OLIMEX/iCE40HX8K-EVB/README.md

# iCE40HX8K-EVB
iCE40HX8K development board with SRAM and bus for fast ADC, DAC, IOs
