OLIMEX/iCE40HX8K-EVB/demo/ice40hx8k-evb/README

This example is for iCE40HX8K-EVB board 

www.olimex.com/wiki/iCE40HX8K-EVB

you need OLIMEXINO-32U4 set as programmer to program the board
