OLIMEX/iCE40HX8K-EVB/HARDWARE/REV-B1/iCE40HX8K-EVB_Rev_B1.pdf

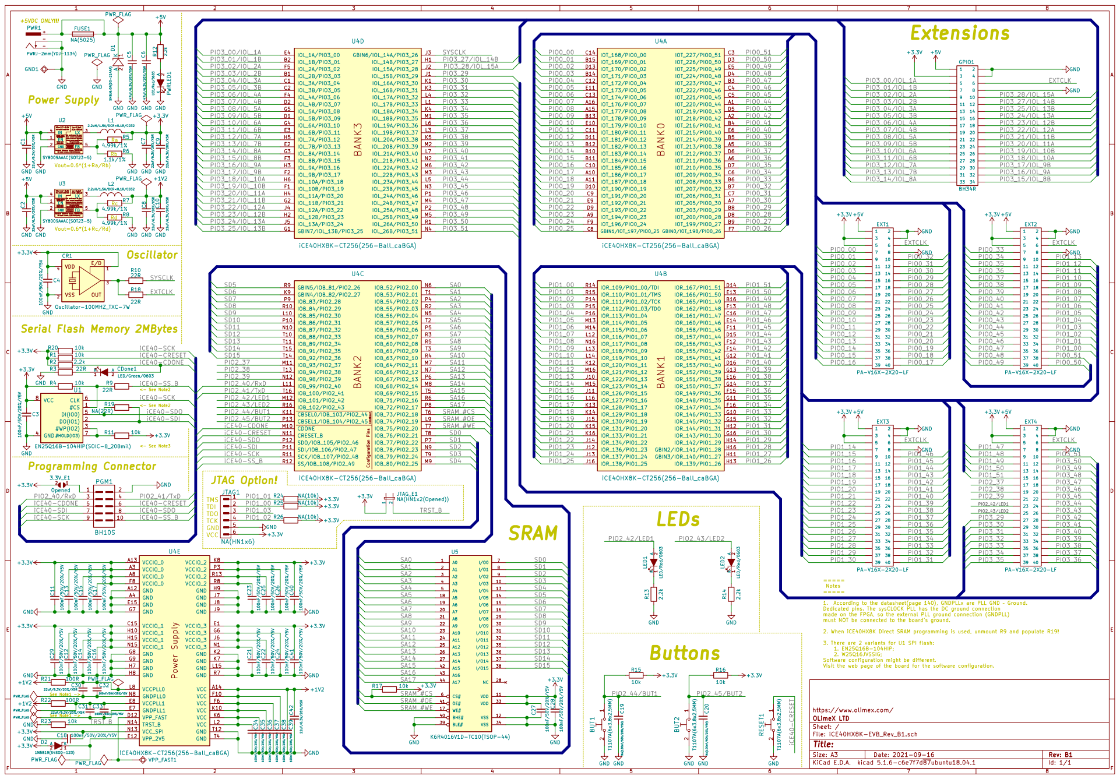
[picture p1: page 1]

Do not float. Enable control. FB Input Current, I(FB)=50nA(max) Feedback Reference Voltage, V(REF)=0.6V

load current capability! Lx=2.2uH

1. According to the datasheet(page 140), GNDPLLx are PLL GND Ground. Dedicated pins. The sysCLOCK PLL has the DC ground connection made on the FPGA, so the external PLL ground connection (GNDPLL) must NOT be connected to the boards ground. 2. When iCE40HX8K Direct SRAM programming is used, unmount R9 and populate R19! 3. There are 2 variants for U1 SPI flash:

1. EN25Q16B-104HIP;
2. W25Q16JVSSIG; Software configuration might be different. Visit the web page of the board for the software configuration.

https://www.olimex.com/
Id: 1/1 Title: File: iCE40HX8K-EVB_Rev_B1.sch Sheet: / OLimeX LTD
