OLIMEX/iCE40HX8K-EVB/HARDWARE/REV-B/iCE40HX8K-EVB_Rev_B.pdf

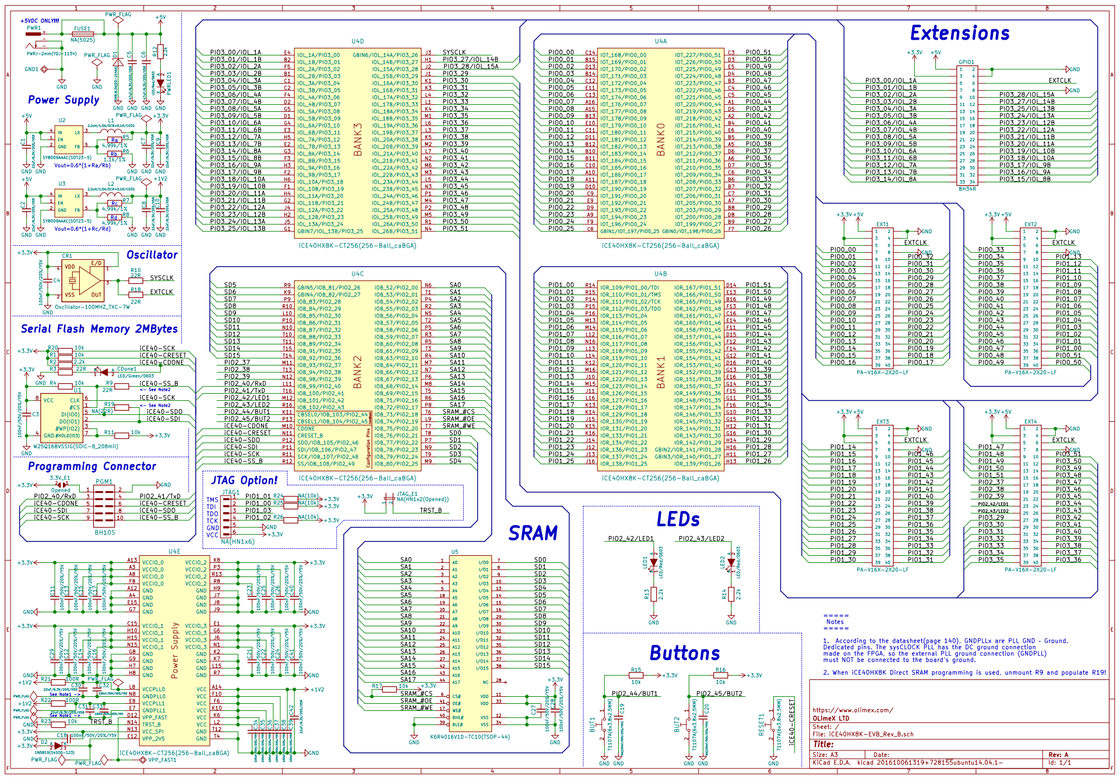
[picture p2: page 1]

2 PWRLED1 LED/Red/0603 R12 2.2k GND C1 22uF/6.3V/20%/X5R GND
iCE40HX8K-CT256(256-Ball_caBGA) BANK3

https://www.olimex.com/
Id: 1/1 Title: File: iCE40HX8K-EVB_Rev_B.sch Sheet: / OLimeX LTD
