OLIMEX/iCE40HX8K-EVB/HARDWARE/REV-B1/iCE40HX8K-EVB_Rev_B1.kicad_pcb

## KiCad design HARDWARE/REV-B1/iCE40HX8K-EVB_Rev_B1.kicad_pcb (2021-09-16)

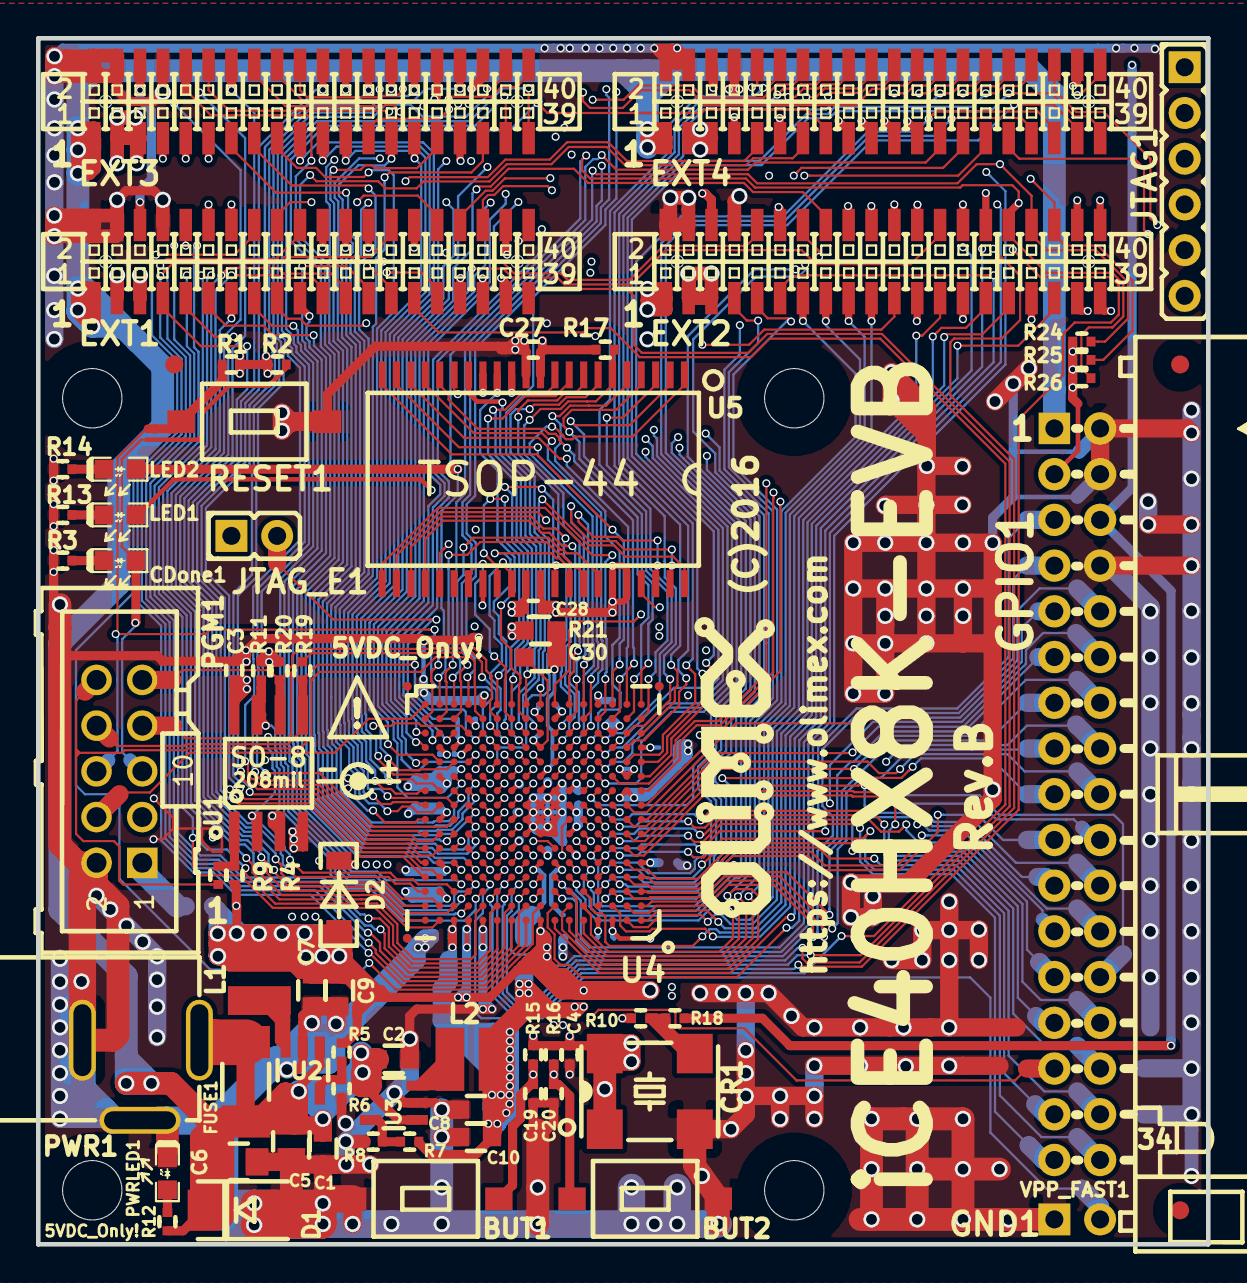
[picture p3: board iCE40HX8K-EVB_Rev_B1.kicad_pcb from above]

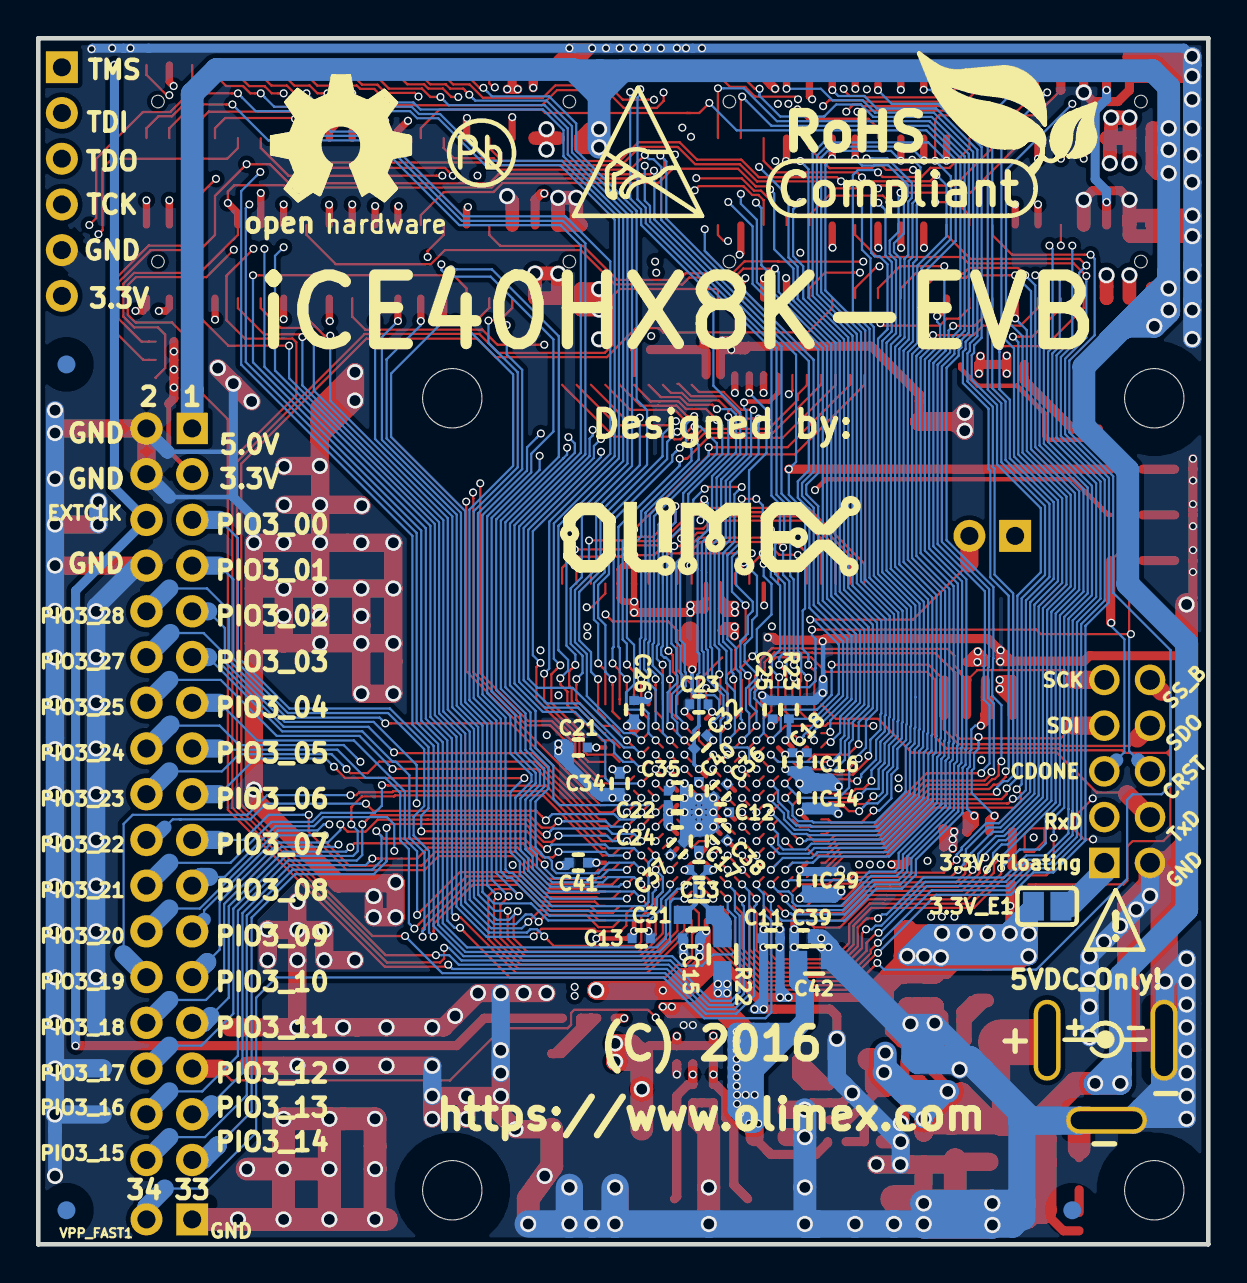
[picture p4: board iCE40HX8K-EVB_Rev_B1.kicad_pcb from below]

Board: 4 copper layers, 65.0 x 67.0 mm, 104 parts (32 on the bottom side), 232 nets.

Parts:
3.3V_E1: Opened; SJ
BUT1, BUT2: T1107A(6x3,8x2,5MM)
C1, C2, C7, C8, C9, C10, C30, C31, C42: 22uF/6.3V/20%/X5R; C_0603_5MIL_DWS
C3, C4, C11, C12, C13, C14, C15, C16, C17, C18, C21, C22, C23, C24, C25, C26, C27, C28, C29, C32, C33, C34, C35, C36, C37, C38, C39, C40, C41: 100nF/50V/20%/Y5V; C_0402_5MIL_DWS
C5, C6: 47uF/6.3V/20%/X5R; C_0805_5MIL_DWS
C19, C20: NA(100nF/50V/20%/Y5V); C_0402_5MIL_DWS
CDone1: LED/Green/0603; LED_0603_KA
CR1: Oscillator-100MHZ_TXC-7W; Oscillator_7.0x5.0mm
D1: SMBJ6.0A(DO-214AA); DO214AA_1(K)-2(A)
D2: 1N5819(S4SOD-123); SOD-123_1C-2A_KA
EXT1, EXT2, EXT3, EXT4: PA-V16X-2X20-LF; GPH127SMT-02X20(PA-V16X-2X20-LF)
FUSE1: NA(5025); FUSE-5025
GND1: TESTPAD; TEST_PAD40x70_SQUARE
GPIO1: BH34R
JTAG1: NA(HN1x6); HN1x6
JTAG_E1: NA(HN1x2(Opened)); HN1x2
L1, L2: 2.2uH/1.5A/DCR<0.1R/CD32; CD32
LED1, LED2: LED/Red/0603; LED_0603_KA
MountingHole: Mounting_hole_3.3mm
MountingHole#2, MountingHole#3, MountingHole#4: Mounting_hole_3.3mm
PGM1: BH10S; UEXT_ML10
PWR1: PWRJ-2mm(YDJ-1134); PWRJ-2mm(YDJ-1136)
PWRLED1: LED/Red/0603; LED_0603_KA
R1, R4, R11, R15, R16, R17, R20, R23: 10k; R_0402_5MIL_DWS
R2, R12, R13, R14: 2.2k; R_0402_5MIL_DWS
R3, R9, R10, R18: 22R; R_0402_5MIL_DWS
R5, R7, R8: 4.99k/1%; R_0402_5MIL_DWS
R6: 1.1k/1%; R_0402_5MIL_DWS
R19: NA(22R); R_0402_5MIL_DWS
R21, R22: 100R; R_0603_5MIL_DWS
R24, R25, R26: NA(10k); R_0402_5MIL_DWS
RESET1: T1107A(6x3,8x2,5MM)
Ref**: Val**; LOGO_ROHS_1
Ref**#2: Val**; LOGO_ANTISTATIC_1
U1: EN25Q16B-104HIP(SOIC-8_208mil); SO-8_208mil
U2, U3: SY8009AAAC(SOT23-5); SOT-23-5
U4: iCE40HX8K-CT256(256-Ball_caBGA); 256-Ball_caBGA(Pitch_0.80mm_Pad_0.40mm)
U5: K6R4016V1D-TC10(TSOP-44); TSOP-44_Pitch-0.80mm_18.80x11.80x1.20mm
VPP_FAST1: TESTPAD; TEST_PAD_40x70_Round

Connections:
+1V2: C8.2, C10.2, C34.2, C35.2, C36.2, C37.2, C38.2, C39.2, C42.1, L2.1, R7.2, R21.2, R22.2, U4.A14, U4.F6, U4.F10, U4.K6, U4.K10, U4.L2
+3V3: 3.3V_E1.2, C3.2, C4.2, C7.2, C9.2, C11.2, C12.2, C13.2, C14.2, C15.2, C16.2, C17.2, C18.1, C21.2, C22.2, C23.2, C24.2, C25.2, C26.2, C27.2, C28.2, C29.2, C40.2, C41.2, CR1.1, CR1.4, D2.2, EXT1.3, EXT1.5, EXT2.3, EXT2.5, EXT3.3, EXT3.5, EXT4.3, EXT4.5, GPIO1.3, JTAG1.6, JTAG_E1.1, L1.1, R1.2, R2.2, R4.2, R5.2, R11.1, R15.2, R16.2, R17.1, R20.2, R24.1, R25.1, R26.1, U1.8, U4.A3, U4.A8, U4.A13, U4.C15, U4.E1, U4.F8, U4.G6, U4.H10, U4.H15, U4.J6, U4.K8, U4.N1, U4.N13, U4.N15, U4.P3, U4.R8, U4.R13, U5.11, U5.33
+5V: C1.2, C2.2, C5.2, C6.2, D1.1, EXT1.1, EXT2.1, EXT3.1, EXT4.1, FUSE1.1, FUSE1.2, GPIO1.1, PWR1.+, R12.1, U2.1, U2.4, U3.1, U3.4
/EXTCLK: EXT1.6, EXT2.6, EXT3.6, EXT4.6, GPIO1.6, R18.1
/PIO0_00: EXT1.7, U4.C14
/PIO0_01: EXT1.9, U4.B15
/PIO0_02: EXT1.11, U4.D13
/PIO0_03: EXT1.13, U4.B14
/PIO0_04: EXT1.15, U4.C12
/PIO0_05: EXT1.17, U4.E11
/PIO0_06: EXT1.19, U4.C13
/PIO0_07: EXT1.21, U4.A16
/PIO0_08: EXT1.23, U4.A15
/PIO0_09: EXT1.25, U4.B13
/PIO0_10: EXT1.27, U4.E10
/PIO0_11: EXT1.29, U4.C11
/PIO0_12: EXT1.31, U4.D11
/PIO0_13: EXT1.33, U4.B12
/PIO0_14: EXT1.35, U4.B10
/PIO0_15: EXT1.37, U4.B11
/PIO0_16: EXT1.39, U4.C10
/PIO0_17: EXT1.40, U4.A10
/PIO0_18: EXT1.38, U4.A11
/PIO0_19: EXT1.36, U4.D10
/PIO0_20: EXT1.34, U4.C9
/PIO0_21: EXT1.32, U4.E9
/PIO0_22: EXT1.30, U4.D9
/PIO0_23: EXT1.28, U4.A9
/PIO0_24: EXT1.26, U4.F9
/PIO0_25: EXT1.24, U4.C8
/PIO0_26: EXT1.22, U4.F7
/PIO0_27: EXT1.20, U4.B9
/PIO0_28: EXT1.18, U4.D8
/PIO0_29: EXT1.16, U4.B8
/PIO0_30: EXT1.14, U4.A7
/PIO0_31: EXT1.12, U4.C7
/PIO0_32: EXT1.10, U4.B7
/PIO0_33: EXT2.7, U4.B6
/PIO0_34: EXT2.9, U4.C6
/PIO0_35: EXT2.11, U4.D7
/PIO0_36: EXT2.13, U4.A6
/PIO0_37: EXT2.15, U4.D6
/PIO0_38: EXT2.17, U4.A5
/PIO0_39: EXT2.19, U4.B5
/PIO0_40: EXT2.21, U4.E6
/PIO0_41: EXT2.23, U4.B4
/PIO0_42: EXT2.25, U4.A2
/PIO0_43: EXT2.27, U4.D5
/PIO0_44: EXT2.29, U4.A1
/PIO0_45: EXT2.31, U4.C5
/PIO0_46: EXT2.33, U4.C4
/PIO0_47: EXT2.35, U4.B3
/PIO0_48: EXT2.37, U4.D4
/PIO0_49: EXT2.39, U4.E5
/PIO0_50: EXT2.40, U4.D3
/PIO0_51: EXT2.38, U4.C3
/PIO1_00: EXT2.36, JTAG1.2, R25.2, U4.R14
/PIO1_01: EXT2.34, JTAG1.1, R24.2, U4.R15
/PIO1_02: EXT2.32, JTAG1.4, R26.2, U4.P14
/PIO1_03: EXT2.30, JTAG1.3, U4.P15
/PIO1_04: EXT2.28, U4.P16
/PIO1_05: EXT2.26, U4.M13
/PIO1_06: EXT2.24, U4.M14
/PIO1_07: EXT2.22, U4.L12
/PIO1_08: EXT2.20, U4.N16
/PIO1_09: EXT2.18, U4.L13
/PIO1_10: EXT2.16, U4.L14
/PIO1_11: EXT2.14, U4.K12
/PIO1_12: EXT2.12, U4.M16
/PIO1_13: EXT2.10, U4.J10
/PIO1_14: EXT3.7, U4.M15
/PIO1_15: EXT3.9, U4.J11
/PIO1_16: EXT3.11, U4.L16
/PIO1_17: EXT3.13, U4.K13
/PIO1_18: EXT3.15, U4.K14
/PIO1_19: EXT3.17, U4.J15
/PIO1_20: EXT3.19, U4.K15
/PIO1_21: EXT3.21, U4.K16
/PIO1_22: EXT3.23, U4.J14
/PIO1_23: EXT3.25, U4.J12
/PIO1_24: EXT3.27, U4.J13
/PIO1_25: EXT3.29, U4.J16
/PIO1_26: EXT3.31, U4.H13
/PIO1_27: EXT3.33, U4.H11
/PIO1_28: EXT3.35, U4.H16
/PIO1_29: EXT3.37, U4.H14
/PIO1_30: EXT3.39, U4.G16
/PIO1_31: EXT3.40, U4.H12
/PIO1_32: EXT3.38, U4.G15
/PIO1_33: EXT3.36, U4.G10
/PIO1_34: EXT3.34, U4.F16
/PIO1_35: EXT3.32, U4.G11
/PIO1_36: EXT3.30, U4.F15
/PIO1_37: EXT3.28, U4.G14
/PIO1_38: EXT3.26, U4.E16
/PIO1_39: EXT3.24, U4.G13
/PIO1_40: EXT3.22, U4.D16
/PIO1_41: EXT3.20, U4.G12
/PIO1_42: EXT3.18, U4.F14
/PIO1_43: EXT3.16, U4.F12
/PIO1_44: EXT3.14, U4.D15
/PIO1_45: EXT3.12, U4.F11
/PIO1_46: EXT3.10, U4.E14
/PIO1_47: EXT4.7, U4.C16
/PIO1_48: EXT4.9, U4.F13
/PIO1_49: EXT4.11, U4.B16
/PIO1_50: EXT4.13, U4.E13
/PIO1_51: EXT4.15, U4.D14
/PIO2_37: EXT4.17, U4.M11
/PIO2_38: EXT4.19, U4.T13
/PIO2_39: EXT4.21, U4.N12
/PIO2_40/RxD: PGM1.3, U4.L11
/PIO2_41/TxD: PGM1.4, U4.T16
/PIO2_42/LED1: EXT4.23, LED1.2, U4.M12
/PIO2_43/LED2: EXT4.25, LED2.2, U4.R16
/PIO2_44/BUT1: BUT1.1, C19.2, R15.1, U4.K11
/PIO2_45/BUT2: BUT2.1, C20.2, R16.1, U4.P13
/PIO3_00/IOL_1A: GPIO1.5, U4.E4
/PIO3_01/IOL_1B: GPIO1.7, U4.B2
/PIO3_02/IOL_2A: GPIO1.9, U4.F5
/PIO3_03/IOL_2B: GPIO1.11, U4.B1
/PIO3_04/IOL_3A: GPIO1.13, U4.C1
/PIO3_05/IOL_3B: GPIO1.15, U4.C2
/PIO3_06/IOL_4A: GPIO1.17, U4.F4
/PIO3_07/IOL_4B: GPIO1.19, U4.D2
/PIO3_08/IOL_5A: GPIO1.21, U4.G5
/PIO3_09/IOL_5B: GPIO1.23, U4.D1
/PIO3_10/IOL_6A: GPIO1.25, U4.G4
/PIO3_11/IOL_6B: GPIO1.27, U4.E3
/PIO3_12/IOL_7A: GPIO1.29, U4.H5
/PIO3_13/IOL_7B: GPIO1.31, U4.E2
/PIO3_14/IOL_8A: GPIO1.33, U4.G3
/PIO3_15/IOL_8B: GPIO1.34, U4.F3
/PIO3_16/IOL_9A: GPIO1.32, U4.H3
/PIO3_17/IOL_9B: GPIO1.30, U4.F2
/PIO3_18/IOL_10A: GPIO1.28, U4.H6
/PIO3_19/IOL_10B: GPIO1.26, U4.F1
/PIO3_20/IOL_11A: GPIO1.24, U4.H4
/PIO3_21/IOL_11B: GPIO1.22, U4.G2
/PIO3_22/IOL_12A: GPIO1.20, U4.J4
/PIO3_23/IOL_12B: GPIO1.18, U4.H2
/PIO3_24/IOL_13A: GPIO1.16, U4.J5
/PIO3_25/IOL_13B: GPIO1.14, U4.G1
/PIO3_27/IOL_14B: GPIO1.12, U4.H1
/PIO3_28/IOL_15A: GPIO1.10, U4.J2
/PIO3_29: EXT4.27, U4.J1
/PIO3_30: EXT4.29, U4.K1
/PIO3_31: EXT4.31, U4.K3
/PIO3_32: EXT4.33, U4.L4
/PIO3_33: EXT4.35, U4.L1
/PIO3_34: EXT4.37, U4.K4
/PIO3_35: EXT4.39, U4.M1
/PIO3_36: EXT4.40, U4.L6
/PIO3_37: EXT4.38, U4.L3
/PIO3_38: EXT4.36, U4.K5
/PIO3_39: EXT4.34, U4.M2
/PIO3_40: EXT4.32, U4.L7
/PIO3_41: EXT4.30, U4.N2
/PIO3_42: EXT4.28, U4.M6
/PIO3_43: EXT4.26, U4.M3
/PIO3_44: EXT4.24, U4.L5
/PIO3_45: EXT4.22, U4.N3
/PIO3_46: EXT4.20, U4.P1
/PIO3_47: EXT4.18, U4.M4
/PIO3_48: EXT4.16, U4.P2
/PIO3_49: EXT4.14, U4.M5
/PIO3_50: EXT4.12, U4.R1
/PIO3_51: EXT4.10, U4.N4
/SA0: U4.N6, U5.1
/SA1: U4.T1, U5.2
/SA2: U4.P4, U5.3
/SA3: U4.R2, U5.4
/SA4: U4.N5, U5.5
/SA5: U4.T2, U5.18
/SA6: U4.P5, U5.19
/SA7: U4.R3, U5.20
/SA8: U4.R5, U5.21
/SA9: U4.T3, U5.22
/SA10: U4.R4, U5.23
/SA11: U4.M7, U5.24
/SA12: U4.N7, U5.25
/SA13: U4.P6, U5.26
/SA14: U4.M8, U5.27
/SA15: U4.T5, U5.42
/SA16: U4.R6, U5.43
/SA17: U4.P8, U5.44
/SD0: U4.T8, U5.7
/SD1: U4.P7, U5.8
/SD2: U4.N9, U5.9
/SD3: U4.T9, U5.10
/SD4: U4.M9, U5.13
/SD5: U4.R9, U5.14
/SD6: U4.K9, U5.15
/SD7: U4.P9, U5.16
/SD8: U4.R10, U5.29
/SD9: U4.L10, U5.30
/SD10: U4.P10, U5.31
/SD11: U4.N10, U5.32
/SD12: U4.T10, U5.35
/SD13: U4.T11, U5.36
/SD14: U4.T15, U5.37
/SD15: U4.T14, U5.38
/SRAM_#CS: R17.2, U4.T6, U5.6
/SRAM_#OE: U4.L9, U5.41
/SRAM_#WE: U4.T7, U5.17
/SYSCLK: R10.1, U4.J3
/TRST_B: JTAG_E1.2, R23.1, U4.N14
/iCE40-CDONE: CDone1.2, PGM1.5, R2.1, U4.M10
/iCE40-CRESET: PGM1.6, R1.1, RESET1.1, U4.N11
/iCE40-SCK: PGM1.9, R20.1, U1.6, U4.R11
/iCE40-SDI: PGM1.7, R19.1, U1.2, U4.P11
/iCE40-SDO: PGM1.8, R19.2, U1.5, U4.P12
/iCE40-SS_B: PGM1.10, R9.1, U4.R12
GND: BUT1.2, BUT2.2, C1.1, C2.1, C3.1, C4.1, C5.1, C6.1, C7.1, C8.1, C9.1, C10.1, C11.1, C12.1, C13.1, C14.1, C15.1, C16.1, C17.1, C18.2, C19.1, C20.1, C21.1, C22.1, C23.1, C24.1, C25.1, C26.1, C27.1, C28.1, C29.1, C34.1, C35.1, C36.1, C37.1, C38.1, C39.1, C40.1, C41.1, C42.2, CR1.2, D1.2, EXT1.2, EXT1.4, EXT1.8, EXT2.2, EXT2.4, EXT2.8, EXT3.2, EXT3.4, EXT3.8, EXT4.2, EXT4.4, EXT4.8, GND1.1, GPIO1.2, GPIO1.4, GPIO1.8, JTAG1.5, PGM1.2, PWR1.-, PWRLED1.1, R3.2, R6.2, R8.2, R13.2, R14.2, R23.2, RESET1.2, U1.4, U2.2, U3.2, U4.A4, U4.A12, U4.E15, U4.G7, U4.G8, U4.G9, U4.H7, U4.H8, U4.H9, U4.J7, U4.J8, U4.J9, U4.K2, U4.K7, U4.L15, U4.R7, U4.T4, U4.T12, U5.12, U5.34, U5.39, U5.40
unnamed: 3.3V_E1.1, PGM1.1
unnamed: C30.1, C32.2, R21.1, U4.L8
unnamed: C30.2, C32.1, U4.N8
unnamed: C31.1, C33.2, R22.1, U4.E8
unnamed: C31.2, C33.1, U4.E7
unnamed: CDone1.1, R3.1
unnamed: CR1.3, R10.2, R18.2
unnamed: D2.1, U4.E12
unnamed: L1.2, U2.3
unnamed: L2.2, U3.3
unnamed: LED1.1, R13.1
unnamed: LED2.1, R14.1
unnamed: PWRLED1.2, R12.2
unnamed: R4.1, R9.2, U1.1
unnamed: R5.1, R6.1, U2.5
unnamed: R7.1, R8.1, U3.5
unnamed: R11.2, U1.3, U1.7
unnamed: U4.D12, VPP_FAST1.1
