OLIMEX/iCE40HX8K-EVB/(commit log)

2017-06-22 iCE40HX8K-EVB Rev.B CAD files
    [iCE40HX8K-EVB_Rev_B-BOM.ods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]
2017-08-23 Add the LEDs blink demo for this evaluation board
2017-08-23 Add the VGA demo for this evaluation board
2021-09-16 Update
    Revision B1
    [iCE40HX8K-EVB_Rev_B-B.Cu.gbr, iCE40HX8K-EVB_Rev_B-B.Mask.gbr, iCE40HX8K-EVB_Rev_B-B.Paste.gbr, iCE40HX8K-EVB_Rev_B-B.SilkS.gbr, iCE40HX8K-EVB_Rev_B-Edge.Cuts.gbr, iCE40HX8K-EVB_Rev_B-F.Cu.gbr, iCE40HX8K-EVB_Rev_B-F.Mask.gbr, iCE40HX8K-EVB_Rev_B-F.Paste.gbr]
2024-10-10 Switch examples to use `nextpnr-ice40` instead of deprecated `arachne-pnr`
    - Also updated gitignore files to include new output generated json file
