OLIMEX/iCE40HX8K-EVB/(notices)

Notices in the files:
HARDWARE/REV-B1/iCE40HX8K-EVB_Rev_B1.kicad_pcb:
(C)2016
